solokeys/solo-hw/kicad/3d/wurth_632712000112_usb-c.step

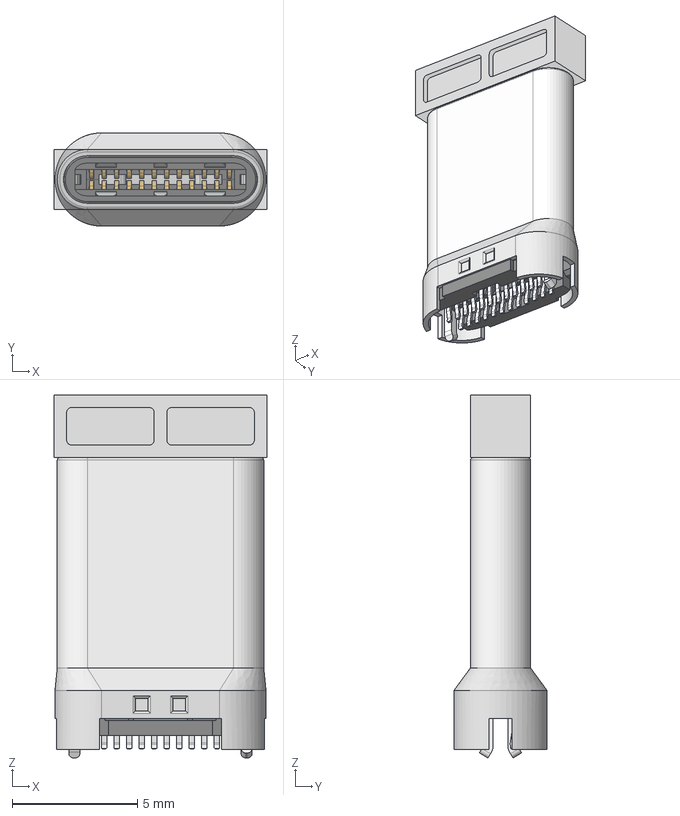
[picture p1: CAD file, 2019-12-21]
kicad/3d/wurth_632712000112_usb-c.step
8.50 x 3.72 x 14.5 mm
632712000112_Shelding
632712000112_Housing1
632712000112_Housing2 x 2
632712000112_Pin x 24
632712000112_Shelding2.asm x 2
632712000112_Shelding3.asm
632712000112_Mylar x 2
632712000112_Cap
