solokeys/solo-hw/kicad/covers/cover-a.step

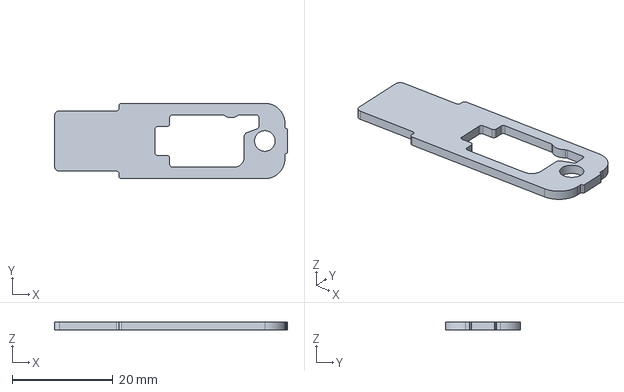
[picture p2: CAD file, 2019-12-14]
kicad/covers/cover-a.step
46.3 x 15.0 x 1.60 mm
