solokeys/solo-hw/kicad/3d/USON8_2-3mm.step

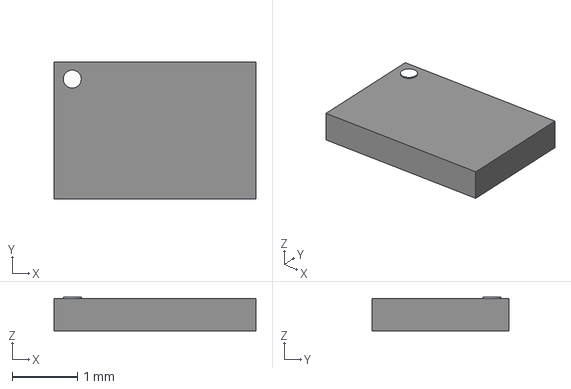
[picture p3: CAD file, 2019-12-14]
kicad/3d/USON8_2-3mm.step
3.10 x 2.10 x 0.52 mm
