solokeys/solo-hw/kicad/3d/FSUSB42.step

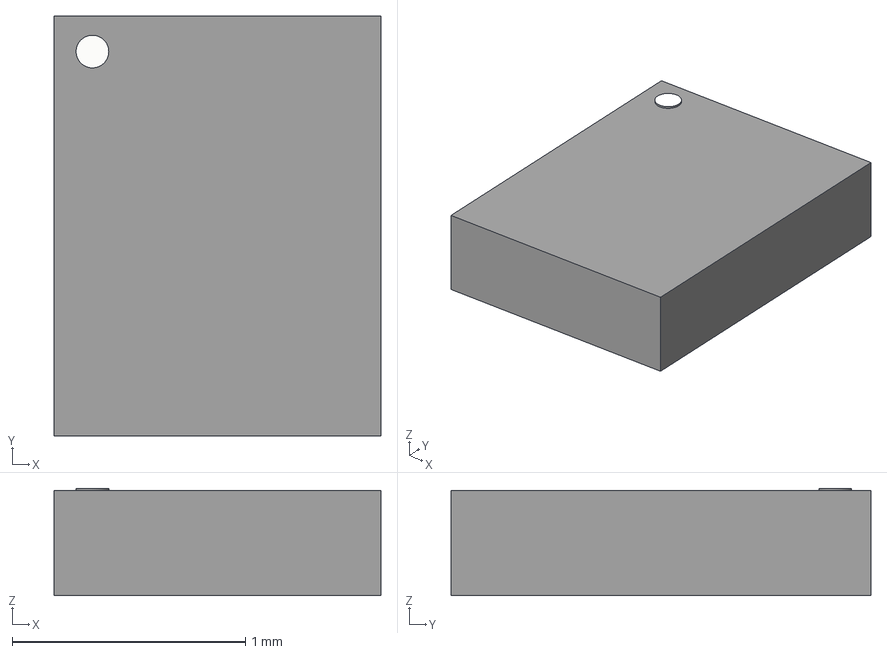
[picture p4: CAD file, 2019-12-08]
kicad/3d/FSUSB42.step
1.40 x 1.80 x 0.46 mm
