solokeys/solo-hw/kicad/3d/ST-BAT30F4.step

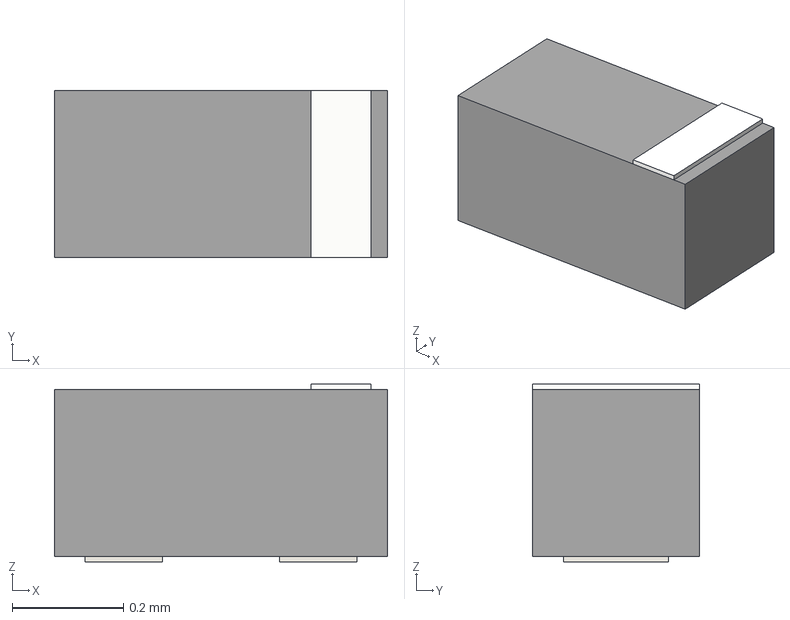
[picture p5: CAD file, 2019-12-08]
kicad/3d/ST-BAT30F4.step
0.6 x 0.3 x 0.32 mm
