solokeys/solo-hw/kicad/3d/tlv742p.step

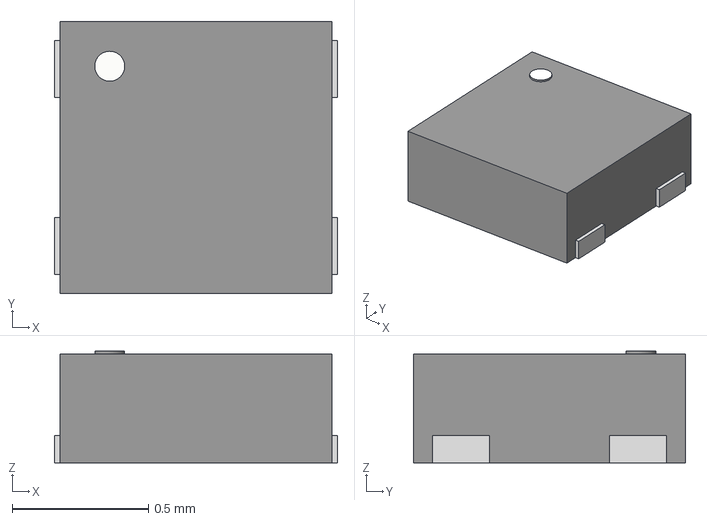
[picture p6: CAD file, 2019-11-26]
kicad/3d/tlv742p.step
1.04 x 1.00 x 0.41 mm
