solokeys/solo-hw/kicad/3d/lpc55.step

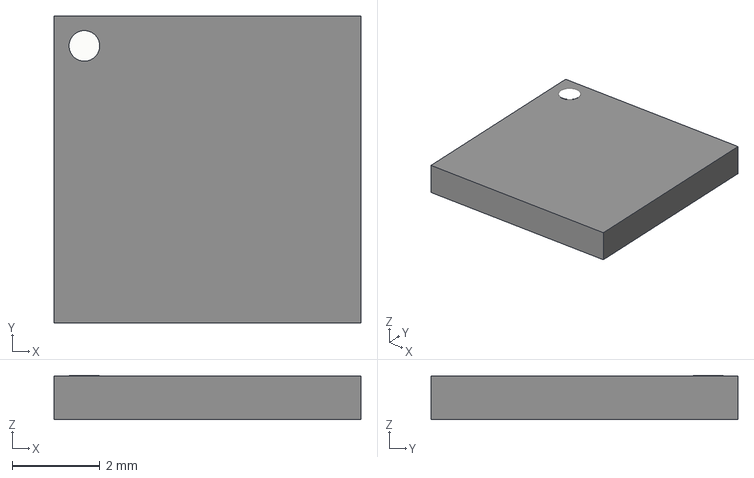
[picture p7: CAD file, 2019-11-26]
kicad/3d/lpc55.step
7.00 x 7.00 x 1.01 mm
