solokeys/solo-hw/kicad/3d/EAST1616RGBB4.step

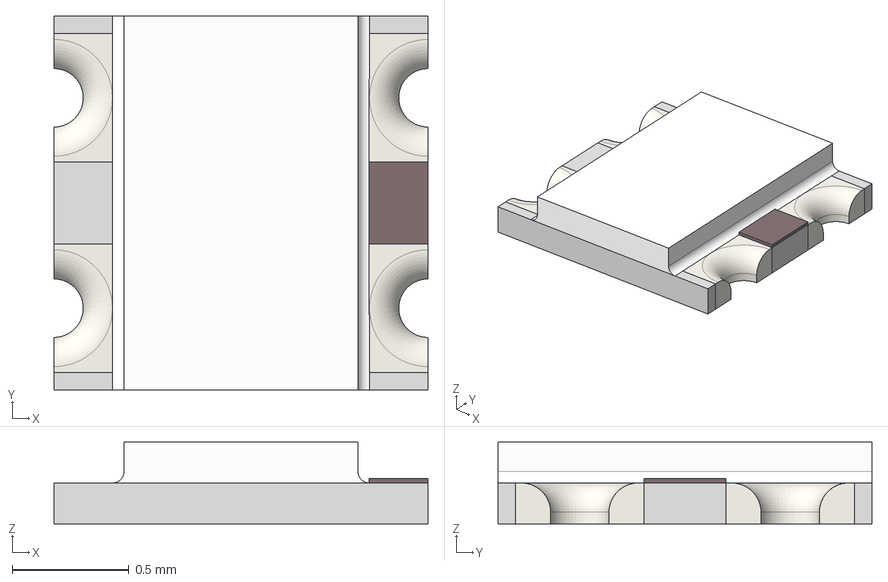
[picture p8: CAD file, 2019-11-26]
kicad/3d/EAST1616RGBB4.step
1.60 x 1.60 x 0.35 mm
