solokeys/solo-hw/kicad/3d/AS3956-CSP.step

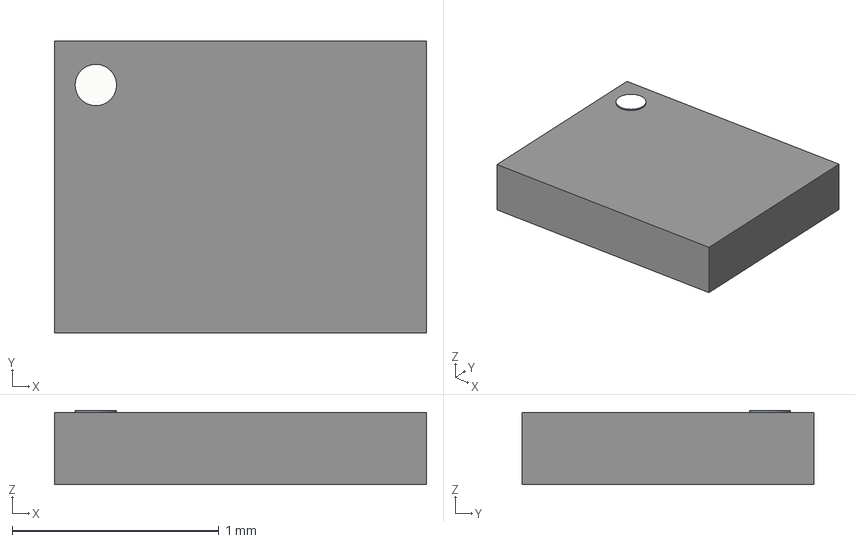
[picture p9: CAD file, 2019-11-26]
kicad/3d/AS3956-CSP.step
1.80 x 1.41 x 0.36 mm
