solokeys/solo-hw/(threads)

Thread 1 (2019-01-07):

Invalid USB plug traces

szszszsz, 2019-01-07:
Hi!
In [USB-A_schematic.pdf] there seems to be a typo in USB plug traces. Signal wires should be alternate to power, not adjacent.
Is: `5V, D+, D-, GND`.
Should be: `5V, D-, D+, GND`.

[USB-A_schematic.pdf]: https://github.com/solokeys/solo-hw/releases/download/1.2/USB-A_schematic.pdf

--------------------------

Details:

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

NeoFromMatrix, 2019-03-15:
I think this is more a personal preference. Also usually the supply rails are on the top and GND on the bottom, but again, I don't think they strictly need to follow the physical layout as long as the logical/net list layout is correct.

The problem I can see is that the USB connector has no GND connection?!?

conorpp, 2019-03-15:
I believe the order of the pins was just the order of the symbol I copied from the eagle library.  Yeah no ground connection, I add it with a pour in layout.  I switched to this because combining a normal pad and ground plane was a bit problematic.  Could also be that I'm very good with Eagle haha.

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

NeoFromMatrix, 2019-03-15:
Having the connection only in the layout but not schematics/netlist is a bit hacky. Why did you need to combine a pad and polygon? A clean footprint should work :)

conorpp, 2019-03-15:
If I remember correctly, that's what I originally had, but the ground planes didn't "mate" with the ground rectangle nicely, so I switched to this.  In other words, I'm bad with Eagle haha.

Now there are no ground planes (because NFC) so it makes even more sense now to fix the footprint haha.

NeoFromMatrix, 2019-03-15:
Uhm, the USB-C version has the USB data lines only connected on top, but not bottom layer.
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 Image from KiCads gerber viewer.

So far I've only seen people using USB data line pads connected on top and bottom, but not only a single one.
(e.g. https://www.orcad.com/cn/node/6481, https://e2e.ti.com/support/interface/f/138/t/512449?Type-C-Connector-Layout-Made-easy)

The data lines are also not routed as differential pair. This could be improved. USB FS should not be too picky, but still.

conorpp, 2019-03-15:
Socket/host-side connectors need to have both top and bottom connected.  As a result, the device only needs to connect to one side.  Only works since the pins are in the middle.

Thread 3 (2019-03-15):

solo nfc hardware design files

NeoFromMatrix, 2019-03-15:
I guess the design is not yet finalized and no one wants to release an unfinished buggy product.
So I assume it will be available when production readiness and or certification is reached.

conorpp, 2019-03-16:
the files are in master currently if you want to peak :)  I'm planning to release once the first production is finished.

NeoFromMatrix, 2019-03-16:
Nice :) I took a quick look at it and have following thoughts:

* It's always good to have a second source for the parts or a second compatible part if possible. Of course, not necessary for generic parts if they are supplied by your assembly house (e.g. 100nF 0402 15V cap) unless you have special requirements. You could add them in Eagle and then export them with the BOM. I usually add manufacturer part number and distributor part number to the components properties.
* The chosen stm also has a touch controller, so you can also go without tactile button (not for the Kickstarter campaign but for the future, lowers BOM parts count and makes assembly easier;) )
* I assume you disable bootloader mode in software after device is flashed over USB? (hopefully also with setting read out protection level 2, just curious seeing BOOT0 being hardwired to 3v3 -> automatically in boot loader mode)
* Do you think you could implement the NFC antenna on the PCB? This would lower BOM cost, BOM part count and also another step in the assembly.
* You could cram the NFC chip close to the stm32 and also add the jumper SJ2 close to the NFC chip.  (not sure if this breaks compatibility with the silicone cover) Long unconnected wires can act as antenna (SJ2/VP_IO).

* I'd also advise you to post in http://www.eevblog.com/forum/oshw/ , there are a lot of skilled people which might also give you some feedback :)

conorpp, 2019-03-17:
Good advice!  Certainly would be good to have second sources for the ESD protection and 3v3 LDO, and can potentially reduce the BOM cost some.  STM32L4 and NFC IC don't have good replacements currently.

Yes, definitely planning to use touch with the STM on a future HW revision.  The choice for using a button was initially just preference but it's clear now that touch would be superior.

> I assume you disable bootloader mode in software after device is flashed over USB? (hopefully also with setting read out protection level 2, just curious seeing BOOT0 being hardwired to 3v3 -> automatically in boot loader mode)

Yup.  I think it's best to force it in bootloader mode at first, then control how to boot it later via software.

> Do you think you could implement the NFC antenna on the PCB? This would lower BOM cost, BOM part count and also another step in the assembly.

NFC antenna is currently implemented on bottom layer of PCB.  It should be in the latest `.brd` files for A and C.    It was tricky getting it all to fit in USB-C.  I agree also it'd be better for NFC chip to be much closer to ST chip.  I've measured the coupling on the SPI lines and VP_IO though and it's very minor as it is now.

Good idea with EEVblog.  I've never posted there, but will make a note to share!  Maybe I should send some Taps to Dave's mailbag :)

NeoFromMatrix, 2019-03-18:
For microcontroller the only option is probably to take some from the same family (e.g. a mcu with more memory which will be expensive) For the nfc controller there seems to be no alternative (not even different temperature grades). Both are still risky because if the manufacturer cannot provide this chip it's also unlikely that they can provide a slightly different one (I assume different temp grades are coming from the manufacturing line and are just binned).
Just as a general thought, should probably be fine to do it with only a single part and multiple distributors (check out octopart e.g. https://octopart.com/search?q=AS3956)

For the voltage regulator or ESD protection it should be possible to find pin compatible parts from a different manufacturer.

I've also seen someone on a conference talk using ~4-7cm long traces between a mcu and secure element IC to side-channel extract the information between both ICs as this can act as antenna. But I can't find the video (CCC, shmoocon? don't know any more). Also I don't know if this is a valid threat for the threat model. (if you can sniff this data you can also sniff nfc directly)

ccinelli, 2019-06-18:
> For microcontroller the only option is probably to take some from the same family (e.g. a mcu with more memory which will be expensive)

I was poking on https://www.st.com/en/microcontrollers-microprocessors/stm32l4x2.html
The https://www.st.com/en/microcontrollers-microprocessors/stm32l432kb.html that the solo is using costs **$2.18** .

There are other 6 devices in that family that are slightly more expensive but have twice the amount of RAM and FLASH.

- The https://www.st.com/en/microcontrollers-microprocessors/stm32l452re.html costs **$3.30**.
- The https://www.st.com/en/microcontrollers-microprocessors/stm32l452ve.html costs **$3.80**.
- The https://www.st.com/en/microcontrollers-microprocessors/stm32l452ce.html costs **$3.30**.
- The https://www.st.com/en/microcontrollers-microprocessors/stm32l462re.html costs **$3.40**.
- The https://www.st.com/en/microcontrollers-microprocessors/stm32l462ve.html costs **$4.00**.
- The https://www.st.com/en/microcontrollers-microprocessors/stm32l462ce.html costs **3.40**.

I am not sure why the the solo key does not use one of these.
I am pretty sure that people would pay $1-2 extra for one of those for having twice as much memory.

Thread 4 (2019-03-15):

please add production (gerber) data

NeoFromMatrix, 2019-03-15:
Please add a non panelized version of the gerber files.
Also PCB specifications would be helpful (e.g. 1.6mm for USB-A...)

NeoFromMatrix, 2019-03-15:
Are present in releases and not in the repo directly as maintainer wants.

emosenkis, 2019-10-21:
@conorpp can you confirm the following details are correct for all versions of the hardware (I couldn't find this info in the releases)?
PCB thickness: 1.6mm
Copper weight: 1oz.

conorpp, 2019-10-22:
USB-A should be between 2.2-2.4mm.  2.0 is more common and can work, but
will be a bit thin in the USB socket.

USB-C should be 0.8mm.

On Tue, Oct 22, 2019 at 12:18 AM Eitan Mosenkis <notifications@github.com>
wrote:

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

Closed 2019-03-15.

Thread 5 (2019-03-15):

Please add BOM

NeoFromMatrix, 2019-03-15:
Please add a BOM in cvs format for each hw version.

conorpp, 2019-03-15:
In the releases.  I plan to release each hardware revision as a Github release with the respective BOM/Schematic/Gerbers attached.

NeoFromMatrix, 2019-03-15:
Oh, ok, thb. I didn't look there. I can understand the reason to add it under the releases.
Maybe you can also add it to the repo directly, then you'd also get it with a git clone directly.

conorpp, 2019-03-15:
I don't like putting it in git directly, because quickly it will get out of date with layout/schematic changes.

NeoFromMatrix, 2019-03-15:
Ok, I'll close both issues. Thanks for the fast feedback!

Closed 2019-03-15.

Thread 6 (2019-03-15):

Please add schematics as PDF

NeoFromMatrix, 2019-03-15:
Having the schematics as PDF makes it very easy for anyone to view the circuits without installing the EDA. Would be nice to have them.

conorpp, 2019-03-15:
It's in the releases -- does that work?

NeoFromMatrix, 2019-03-15:
Same as #5

Closed 2019-03-15.

Thread 8 (2019-06-27):

Provide a step-by-step guide

LukeMarlin, 2019-06-27:
Would it be possible to provide a step-by-step guide on how to build the key?
Links to buy the components, required tools, and how-tos?

Wesseldr, 2019-08-04:
Or a step by step guide how to get the STM32L432 setup and working and behave like a solo hacker

Wesseldr, 2019-08-04:
I'm doing a sort of on the fly exploring how to get the STM32 working here:
https://github.com/solokeys/solo/issues/235

emosenkis, 2019-10-21:
I put together this shopping cart on Digikey for the Solo Tap C v2.1:
https://www.digikey.com/short/pd8385

@conorpp would you be willing to give this a quick look and confirm if everything here looks right?

Thread 10 (2019-10-21):

Sourcing or replacing the dome button

emosenkis, 2019-10-21:
I'd like to try building a few of these as a SMD practice project but I'm not sure what to do about the dome button, which is listed in the BOM as 'custom'. I found a reference to [Snaptron BL10280](https://www.snaptron.com/part-number/bl10280/) but I'm not sure if that's actually the right part or if they'll accept an order for a very small number of parts. Is there a standard (e.g. available on Digikey) part that I could substitute that would match the footprint and pads? Would it work to simply replace the dome with a copper pour and treat it in software as a capacitative touch button or would that require further modification of the PCB or additional components?

conorpp, 2019-10-22:
Unfortunately the capacitive touch method won't work with the current PCB.  You could edit the firmware to ignore the button, or get a sample of Snaptron's BL series.  Very likely one of them could fit.  If you're considering something more serious, we can connect you with the official button.

nickray, 2019-10-23:
Cool stuff @emosenkis! If you build some, would be interesting to read a blog post on your experience, perhaps we could share appropriately if you're interested.

kyleharte, 2021-01-26:
> Unfortunately the capacitive touch method won't work with the current PCB. You could edit the firmware to ignore the button, or get a sample of Snaptron's BL series. Very likely one of them could fit. If you're considering something more serious, we can connect you with the official button.

Hey, if you could hook me up with the official button I would be so grateful.

Thread 12 (2019-11-10):

Publish design files for 3d-printable case

emosenkis, 2019-11-10:
If you have any design files for a 3d-printable case that you'd be willing to share, that would be awesome!

conorpp, 2019-11-11:
Our designs are for molded silicone, and very likely won't work well 3D printed.  I can publish step files for the PCBs though if you want to make a new 3D printed case.

emosenkis, 2019-11-11:
@conorpp I assume that I can export the PCB info from Eagle myself. Are your design files in a format that might be a good starting point for making a 3D printed case? If not, I'll just stay from scratch.

nilsalexander, 2020-07-09:
Hi, what about files for a 3d-printable somu case? I saw you made some for prototyping in your crowdfunding campaign and i'd love to be able to print some myself :)

Thread 14 (2020-12-02):

USB-C connector reliability

tomtom5152, 2020-12-02:
Having happily had my Solo Tap USB-C for about 6 months now, and despite not plugging it in much, I've frequently had issues with the USB-C connector, often resulting in a lot of finessing to get it to receive data to authenticate.

The first time I assumed it was just a bad solder joint so reflowed it with hot air and it seems to hold, but having just had the same issue again, to the point where the connector almost fell off, I'm thinking there may be a more systemic problem with the overall design where the connector is as exposed as it is on the end of the key. I've repaired it again with some extra solder on the side tabs to reinforce it, and reflowed with ample flux paste to ensure a good joint across all the pins, but thought it worth reporting incase others have had similar issues that could indicate a redesign is needed.

patrick-othmer, 2021-01-26:
@tomtom5152 Check out the new v2 design: https://www.kickstarter.com/projects/conorpatrick/solo-v2-safety-net-against-phishing/description

It should have a more robust case.

Thread 15 (2021-04-26):

Chip selection problems

953077065, 2021-04-26:
Q1: In the BOM list `Z1 - BZA900A` is a series contains `BZA956A/BZA962A/BZA968A` , which one can I ues ?
Q2: About the NFC IC , can I use `AS3956-ATDT-S4` instead of  `AS3956-ATDM-S4`?
