solokeys/solo-hw/(commit log)

2018-11-27 add molex nfc antenna/coil
    [chipset.brd, chipset.sch]
2018-12-06 fix AMS part footprint :(
    [USB-A.brd, USB-A.sch]
2018-12-30 update chipset
    [chipset.brd, chipset.sch]
2018-12-31 added snapshot of managed library
    [USB-A.brd]
2019-01-23 use hatched footprints, remove bridge
    [USB-A.brd, USB-A.sch]
2019-01-26 prep for nfc
    [USB-A.brd, USB-A.sch]
2019-03-14 NFC designs
    [USB-A.brd, USB-A.sch, USB-C.brd, USB-C.sch]
2019-03-14 go back to using old LED
    [USB-A.brd, USB-A.sch, USB-C.brd, USB-C.sch]
2019-04-11 Update footprints from manufacturer comments
    [USB-A.brd, USB-A.sch, USB-C.brd, USB-C.sch]
2019-04-14 add solo somu
    [USB-nano.brd, USB-nano.sch]
2019-04-16 update libraries
    [USB-A.brd, USB-A.sch, USB-C.brd, USB-C.sch, USB-nano.brd]
2019-04-16 update button outline
    [USB-nano.brd, USB-nano.sch]
2019-07-05 update cap values
    [USB-A.sch, USB-C.sch]
2019-11-26 first draft of kicad schematic + layout with NXP chip
    [AS3956-CSP.step, EAST1616RGBB4.step, LPC55Sxx.sch, lpc55.step, solo-A.kicad_pcb, solo-A.sch, solo.sch, tlv742p.step]
2019-12-02 kicad solo2 progress
    [solo-A.kicad_pcb, solo.sch]
2019-12-02 reorg kicad
    [AS3956-CSP.step, EAST1616RGBB4.step, LPC55Sxx.sch, lpc55.step, solo-A.kicad_pcb, solo-A.sch, solo.sch, tlv742p.step]
2019-12-07 route cap touch buttons
    [LPC55Sxx.sch, solo-A.kicad_pcb, solo-A.sch, solo.sch]
2019-12-07 reversible usb-a frontend routed
    [LPC55Sxx.sch, solo-A.kicad_pcb, solo-A.sch, solo.sch]
2019-12-08 layout cleanup + 3d models
    [FSUSB42.step, LPC55Sxx.sch, ST-BAT30F4.step, solo-A.kicad_pcb, solo-A.sch, solo.sch]
2019-12-08 make usb traces diff pairs and add 33 ohm termination
    [LPC55Sxx.sch, solo-A.kicad_pcb, solo-A.sch]
2019-12-08 reorg silkscreen
    [solo-A.kicad_pcb]
2019-12-09 add dcdc components
    [LPC55Sxx.sch, solo-A.kicad_pcb, solo-A.sch, solo.sch]
2019-12-09 add flash chip
    [LPC55Sxx.sch, solo-A.kicad_pcb, solo.sch]
2019-12-14 many optimizations, ready for first order
    [LPC55Sxx.sch, USON8_2-3mm.step, cover-a.kicad_pcb, cover-a.sch, cover-a.step, solo-A.kicad_pcb, solo-A.sch, solo.sch]
2019-12-19 split 0402 22u into 2x 0402 10u
    [LPC55Sxx.sch, solo-A.kicad_pcb]
2019-12-21 fix 3v nc
    [solo-A.kicad_pcb]
2019-12-21 add initial solo-c base layout
    [solo-A.sch, solo-C.kicad_pcb, solo-C.sch, wurth_632712000112_usb-c.step]
2019-12-21 add plating
    [solo-C.kicad_pcb, solo-C.sch]
2019-12-23 usb-c cover
    [cover-c.kicad_pcb, cover-c.sch]
2020-01-13 fix rotated as3953
    [solo-C.kicad_pcb, solo.sch]
